jnedbal/MicroFLiC_DAC_power_supply_1_2/MicroFLiC_DAC_power_supply.kicad_pcb

## KiCad design MicroFLiC_DAC_power_supply.kicad_pcb (2016-03-18)

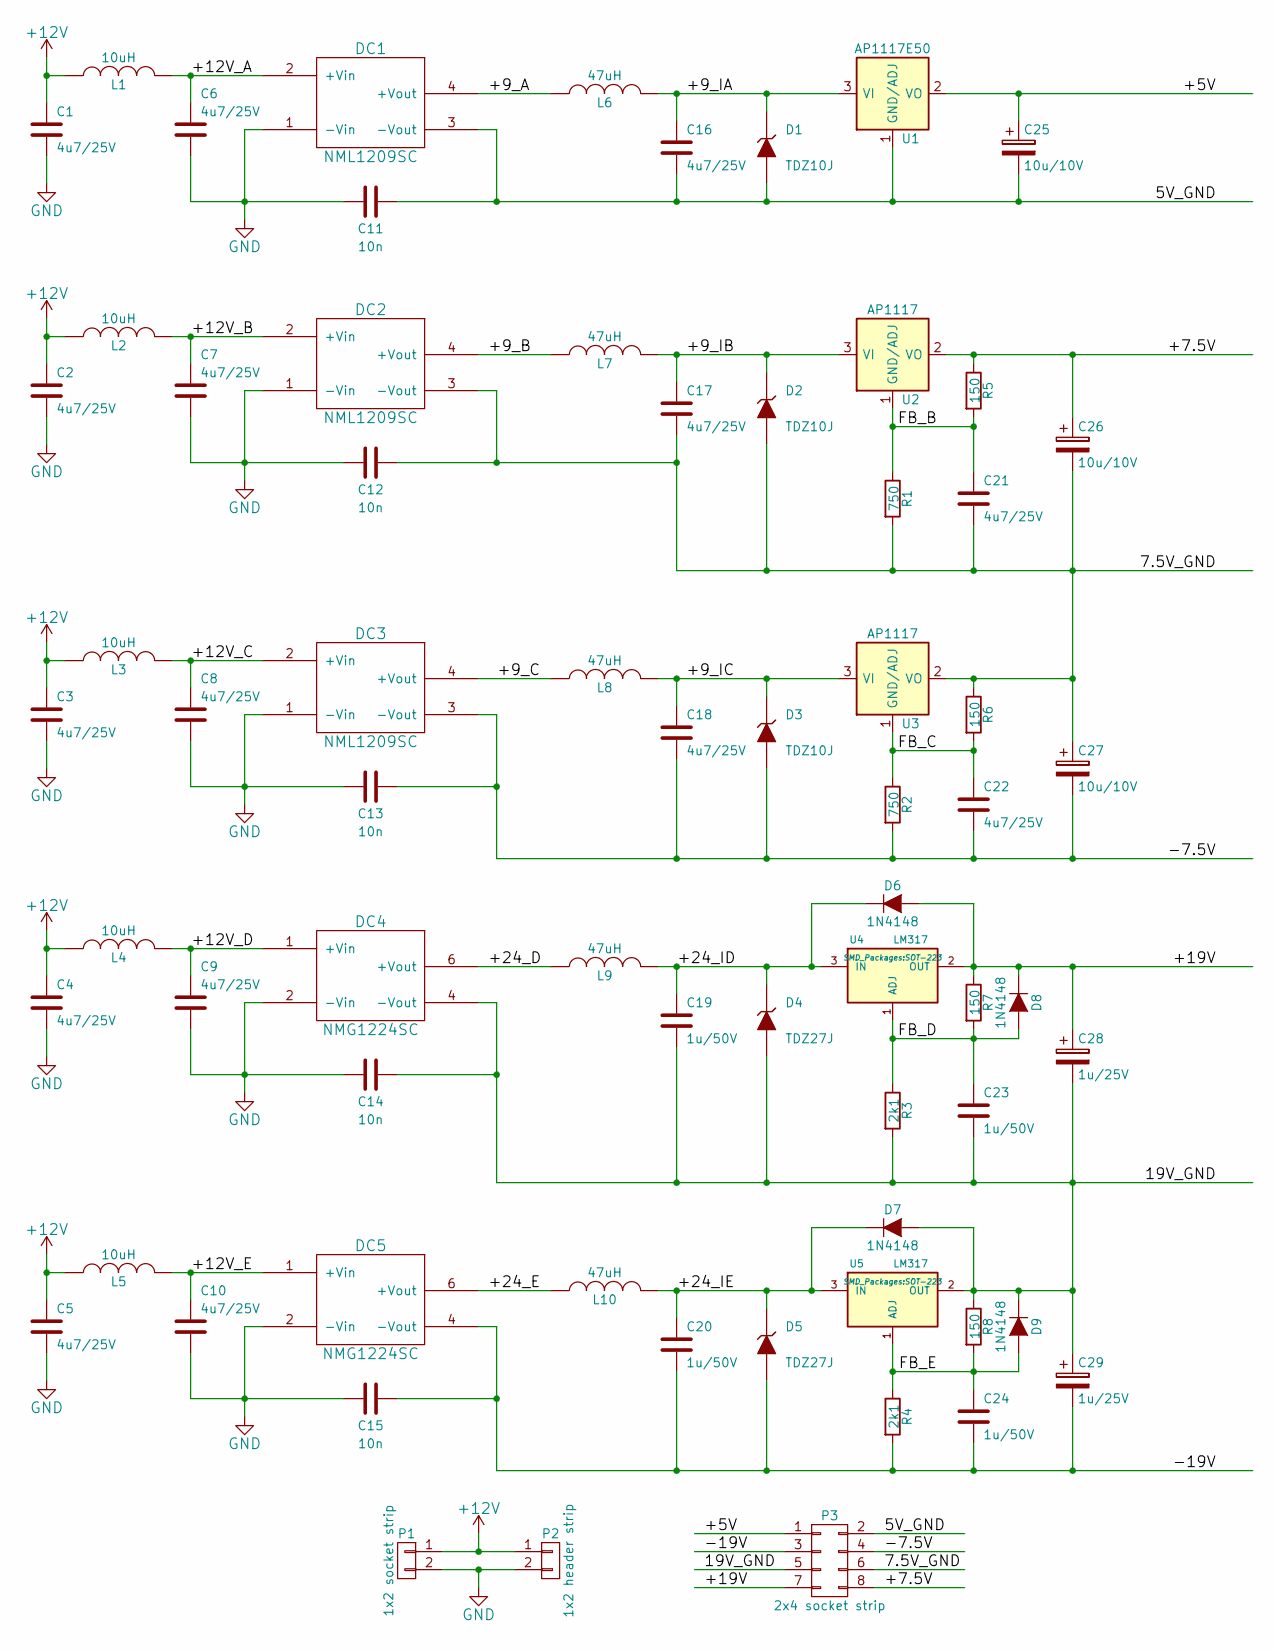
[picture p1: schematic MicroFLiC_DAC_power_supply.sch]

Parts:
C1, C2, C3, C4, C5, C6, C7, C8, C9, C10, C16, C17, C18, C21, C22: 4u7/25V; C_0805; Part Number GRM21BR61E475MA12L
C11, C12, C13, C14, C15: 10n; C_0805; Part Number MCU0805R103KCT
C19, C20, C23, C24: 1u/50V; C_0805; Part Number GRM219R61H105KA73D
C25, C26, C27: 10u/10V; TantalC_SizeA_EIA-3216_Reflow; Part Number TAJA106K010RNJ
C28, C29: 1u/25V; TantalC_SizeA_EIA-3216_Reflow; Part Number TRJA105K025RRJ
D1, D2, D3: TDZ10J; SOD-323_Zener; Part Number TDZ10J
D4, D5: TDZ27J; SOD-323_Zener; Part Number TDZ27J
D6, D7, D8, D9: 1N4148; SOD-323; Part Number 1N4148WS
DC1, DC2, DC3: NML1209SC; MurataNML; Part Number NML1209SC
DC4, DC5: NMG1224SC; MurataNMG; Part Number NMG1224SC
L1, L2, L3, L4, L5: 10uH; murata8200coil; Part Number 7440329100
L6, L7, L8, L9, L10: 47uH; murata8200coil; Part Number 82473C
P1: 1x2 socket strip; ESQ-102-33-G-S; Part Number ESQ-102-33-G-S
P2: 1x2 header strip; Pin_Header_Straight_1x02; Part Number M20-9990245
P3: 2x4 socket strip; ESQ-104-33-G-D; Part Number ESQ-104-33-G-D
R1, R2: 750; R_0805; Part Number MCMR08X7500FTL
R3, R4: 2k1; R_0805; Part Number CRCW08052K10FKEA
R5, R6, R7, R8: 150; R_0805; Part Number MCWR08X1500FTL
U1: AP1117E50; SOT-223; Part Number AP1117E50G-13
U2, U3: AP1117; SOT-223; Part Number AP1117EG-13
U4, U5: LM317; SOT-223; Part Number LM317DCY

Connections:
+12V: C1.1, C2.1, C3.1, C4.1, C5.1, L1.1, L2.1, L3.1, L4.1, L5.1, P1.1, P2.1
/5V_GND: C11.1, C16.2, C25.2, D1.2 (A), DC1.3 (-Vout), P3.2, U1.1 (GND/ADJ)
/7.5V_GND: C12.1, C17.2, C21.2, C26.2, C27.1, D2.2 (A), DC2.3 (-Vout), P3.6, R1.2, R6.1, U3.2 (VO)
/19V_GND: C14.1, C19.2, C23.2, C28.2, C29.1, D4.2 (A), D7.2 (A), D9.1 (K), DC4.4 (-Vout), P3.5, R3.2, R8.1, U5.2 (OUT)
/+5V: C25.1, P3.1, U1.2 (VO)
/+7.5V: C26.1, P3.8, R5.1, U2.2 (VO)
/+9_A: DC1.4 (+Vout), L6.1
/+9_B: DC2.4 (+Vout), L7.1
/+9_C: DC3.4 (+Vout), L8.1
/+9_IA: C16.1, D1.1 (K), L6.2, U1.3 (VI)
/+9_IB: C17.1, D2.1 (K), L7.2, U2.3 (VI)
/+9_IC: C18.1, D3.1 (K), L8.2, U3.3 (VI)
/+12V_A: C6.1, DC1.2 (+Vin), L1.2
/+12V_B: C7.1, DC2.2 (+Vin), L2.2
/+12V_C: C8.1, DC3.2 (+Vin), L3.2
/+12V_D: C9.1, DC4.1 (+Vin), L4.2
/+12V_E: C10.1, DC5.1 (+Vin), L5.2
/+19V: C28.1, D6.2 (A), D8.1 (K), P3.7, R7.1, U4.2 (OUT)
/+24_D: DC4.6 (+Vout), L9.1
/+24_E: DC5.6 (+Vout), L10.1
/+24_ID: C19.1, D4.1 (K), D6.1 (K), L9.2, U4.3 (IN)
/+24_IE: C20.1, D5.1 (K), D7.1 (K), L10.2, U5.3 (IN)
/-7.5V: C13.1, C18.2, C22.2, C27.2, D3.2 (A), DC3.3 (-Vout), P3.4, R2.2
/-19V: C15.1, C20.2, C24.2, C29.2, D5.2 (A), DC5.4 (-Vout), P3.3, R4.2
/FB_B: C21.1, R1.1, R5.2, U2.1 (GND/ADJ)
/FB_C: C22.1, R2.1, R6.2, U3.1 (GND/ADJ)
/FB_D: C23.1, D8.2 (A), R3.1, R7.2, U4.1 (ADJ)
/FB_E: C24.1, D9.2 (A), R4.1, R8.2, U5.1 (ADJ)
GND: C1.2, C2.2, C3.2, C4.2, C5.2, C6.2, C7.2, C8.2, C9.2, C10.2, C11.2, C12.2, C13.2, C14.2, C15.2, DC1.1 (-Vin), DC2.1 (-Vin), DC3.1 (-Vin), DC4.2 (-Vin), DC5.2 (-Vin), P1.2, P2.2

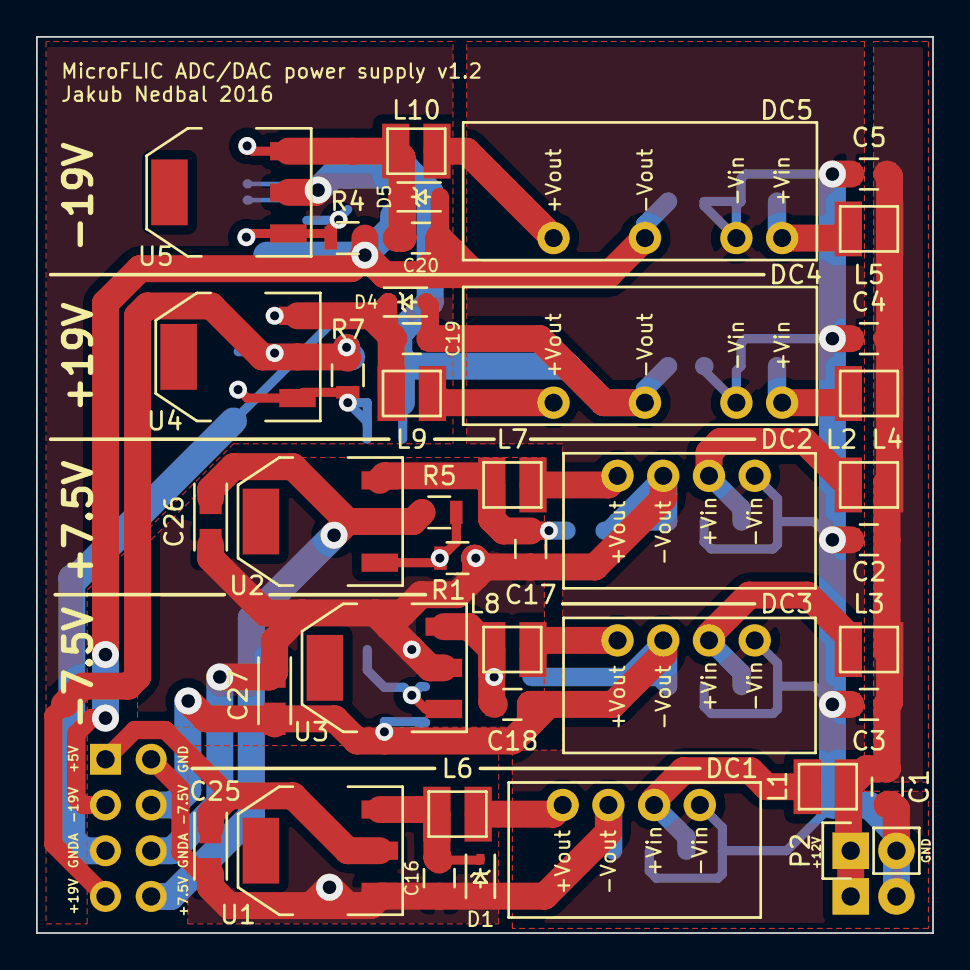
[picture p2: board MicroFLiC_DAC_power_supply.kicad_pcb from above]

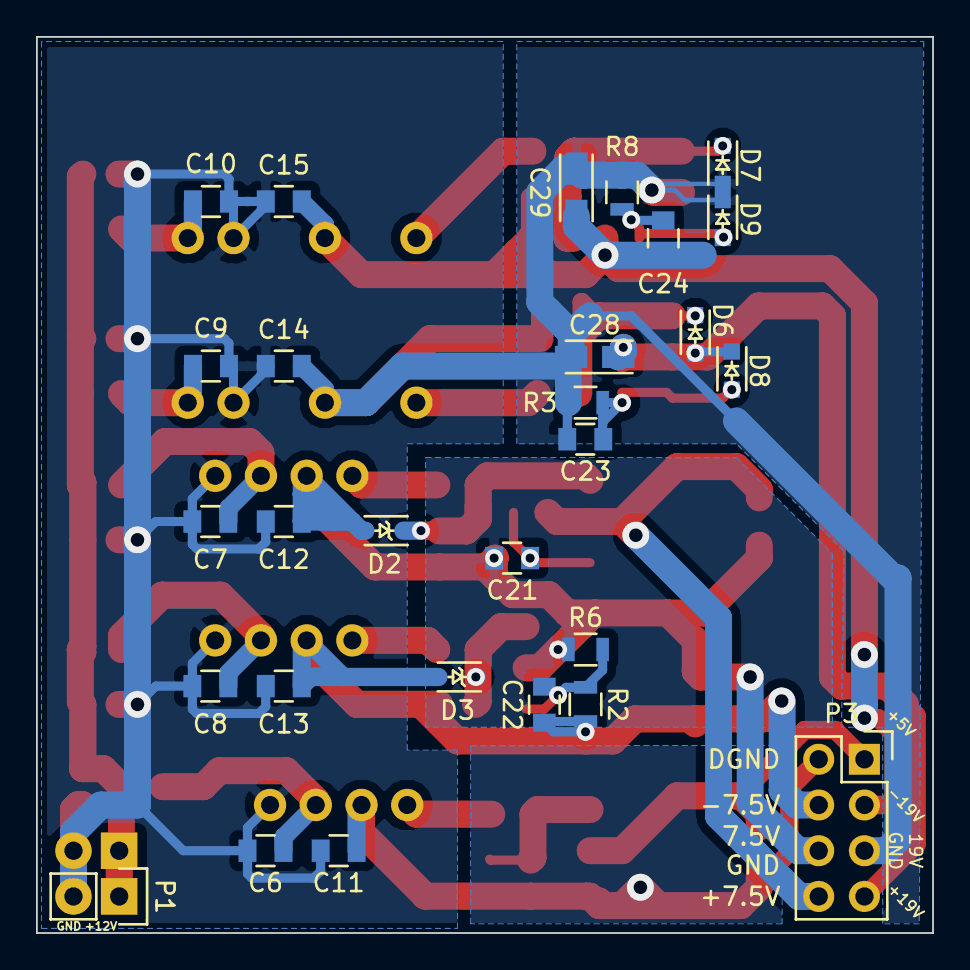
[picture p3: board MicroFLiC_DAC_power_supply.kicad_pcb from below]

Board: 2 copper layers, 49.8 x 49.8 mm, 69 parts (28 on the bottom side), 29 nets.
