jnedbal/MicroFLiC_DAC_power_supply_1_2/(commit log)

2016-02-02 Version 1.1 with fixed DC-DC controller pinout and extra filtering capacitors.
    [MicroFLiC_DAC_power_supply_1_1.kicad_pcb, MicroFLiC_DAC_power_supply_1_1.sch]
2016-02-02 Completed part descriptions
    [MicroFLiC_DAC_power_supply_1_1.csv, MicroFLiC_DAC_power_supply_1_1.kicad_pcb, MicroFLiC_DAC_power_supply_1_1.sch]
2016-02-03 Added feedback filtering capacitors and protection diodes
    [MicroFLiC_DAC_power_supply_1_1.csv, MicroFLiC_DAC_power_supply_1_1.kicad_pcb, MicroFLiC_DAC_power_supply_1_1.sch]
2016-02-03 Created output files
    [MicroFLiC_DAC_power_supply_1_1-B.Cu.gbl, MicroFLiC_DAC_power_supply_1_1-B.Mask.gbs, MicroFLiC_DAC_power_supply_1_1-B.SilkS.gbo, MicroFLiC_DAC_power_supply_1_1-Edge.Cuts.gm1, MicroFLiC_DAC_power_supply_1_1-F.Cu.gtl, MicroFLiC_DAC_power_supply_1_1-F.Mask.gts, MicroFLiC_DAC_power_supply_1_1-F.SilkS.gto, MicroFLiC_DAC_power_supply_1_1.gbl]
2016-02-03 Added drl file
    [MicroFLiC_DAC_power_supply_1_1.drl]
2016-02-11 Fixed capacitor order code
    [MicroFLiC_DAC_power_supply_1_1-B.Cu.gbl, MicroFLiC_DAC_power_supply_1_1-B.Mask.gbs, MicroFLiC_DAC_power_supply_1_1-B.SilkS.gbo, MicroFLiC_DAC_power_supply_1_1-Edge.Cuts.gm1, MicroFLiC_DAC_power_supply_1_1-F.Cu.gtl, MicroFLiC_DAC_power_supply_1_1-F.Mask.gts, MicroFLiC_DAC_power_supply_1_1-F.SilkS.gto, MicroFLiC_DAC_power_supply_1_1.drl]
2016-02-11 Updated part descriptions
    [MicroFLiC_DAC_power_supply_1_1.csv, MicroFLiC_DAC_power_supply_1_1.kicad_pcb, MicroFLiC_DAC_power_supply_1_1.sch]
2016-02-14 Removed trailing version number
    [MicroFLiC_DAC_power_supply.csv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]
2016-02-14 Fixed capacitor and DC-DC converter descriptiions
    [MicroFLiC_DAC_power_supply.csv, MicroFLiC_DAC_power_supply.sch]
2016-02-17 Fixed LDO feedback resistors and capacitors
    [MicroFLiC_DAC_power_supply.csv, MicroFLiC_DAC_power_supply.kicad_pcb, MicroFLiC_DAC_power_supply.sch]
2016-02-18 Fixed power output connector orientation
    [MicroFLiC_DAC_power_supply.kicad_pcb, MicroFLiC_DAC_power_supply.sch]
2016-02-19 Production files for Seeedstudio
    [MicroFLiC_DAC_power_supply-B.Cu.gbl, MicroFLiC_DAC_power_supply-B.Mask.gbs, MicroFLiC_DAC_power_supply-B.SilkS.gbo, MicroFLiC_DAC_power_supply-Edge.Cuts.gm1, MicroFLiC_DAC_power_supply-F.Cu.gtl, MicroFLiC_DAC_power_supply-F.Mask.gts, MicroFLiC_DAC_power_supply-F.SilkS.gto, MicroFLiC_DAC_power_supply.drl]
2016-02-26 Fixed connector descriptions
    [MicroFLiC_DAC_power_supply.csv, MicroFLiC_DAC_power_supply.sch]
2016-03-18 Changed SOD-323 packages for larger pads.
    [MicroFLiC_DAC_power_supply.csv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]
